whatnick/DrumLights/render/drumlight_still.png

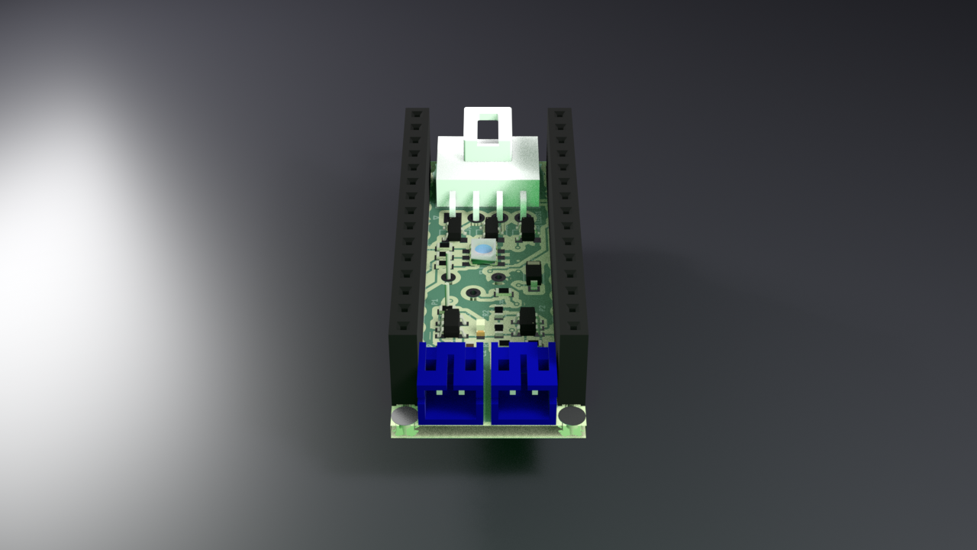
render/drumlight_still.png
