whatnick/DrumLights/Drumlight_PCB/Drumlight_PCB_bom.csv

Refs | Value | Footprint | Manufacturer | MPN | LCSC | DigiKey | Mouser
BAT1,PZO1 | CONN_01X02 | Drumlight_PCB:JST_PH_S2B-PH-K_02x2.00mm_Angled | JST | S2B-PH-K-S(LF)(SN) | C173752 | https://www.digikey.com/en/products/result?keywords=S2B-PH-K-S%28LF%29%28SN%29 | https://www.mouser.com/c/?q=S2B-PH-K-S%28LF%29%28SN%29
C1 | 10pF | Drumlight_PCB:C_0603 | Samsung Electro-Mechanics | CL10C100JB8NNNC | C1634 | https://www.digikey.com/en/products/result?keywords=CL10C100JB8NNNC | https://www.mouser.com/c/?q=CL10C100JB8NNNC
C2,C3 | 4.7uF | Drumlight_PCB:C_0603 | Samsung Electro-Mechanics | CL10A475KO8NNNC | C19666 | https://www.digikey.com/en/products/result?keywords=CL10A475KO8NNNC | https://www.mouser.com/c/?q=CL10A475KO8NNNC
D1 | LED | Drumlight_PCB:LED_0603 | Lite-On | LTST-C191KGKT | C125098 | https://www.digikey.com/en/products/result?keywords=LTST-C191KGKT | https://www.mouser.com/c/?q=LTST-C191KGKT
D2 | D_Schottky | Drumlight_PCB:D_SOD-123 | Jiangsu Changjing Electronics | B5819W SL | C8598 | https://www.digikey.com/en/products/result?keywords=B5819W%20SL | https://www.mouser.com/c/?q=B5819W%20SL
D3 | LED_RGB | Drumlight_PCB:LED_RGB_PLCC-6 | ams OSRAM | LRTB GFTM |  | https://www.digikey.com/en/products/result?keywords=LRTB%20GFTM | https://www.mouser.com/c/?q=LRTB%20GFTM
LEDS1 | CONN_01X04 | Drumlight_PCB:Molex_NanoFit_1x04x2.50mm_Angled | Molex | 105313-1204 | C586244 | https://www.digikey.com/en/products/result?keywords=105313-1204 | https://www.mouser.com/c/?q=105313-1204
P1,P2 | Analog,Digital | Drumlight_PCB:Socket_Strip_Straight_1x15
Q1,Q2,Q3 | BSS306N | Drumlight_PCB:SOT-23 | Infineon | BSS306N H6327 | C72769 | https://www.digikey.com/en/products/result?keywords=BSS306N%20H6327 | https://www.mouser.com/c/?q=BSS306N%20H6327
R1,R2,R6 | 10K | Drumlight_PCB:R_0603 | UNI-ROYAL | 0603WAF1002T5E | C25804 | https://www.digikey.com/en/products/result?keywords=0603WAF1002T5E | https://www.mouser.com/c/?q=0603WAF1002T5E
R3,R8,R9 | 100 | Drumlight_PCB:R_0603 | UNI-ROYAL | 0603WAF1000T5E | C22775 | https://www.digikey.com/en/products/result?keywords=0603WAF1000T5E | https://www.mouser.com/c/?q=0603WAF1000T5E
R4 | 100K | Drumlight_PCB:R_0603 | UNI-ROYAL | 0603WAF1003T5E | C25803 | https://www.digikey.com/en/products/result?keywords=0603WAF1003T5E | https://www.mouser.com/c/?q=0603WAF1003T5E
R5 | 470 | Drumlight_PCB:R_0603 | UNI-ROYAL | 0603WAF4700T5E | C23179 | https://www.digikey.com/en/products/result?keywords=0603WAF4700T5E | https://www.mouser.com/c/?q=0603WAF4700T5E
R7 | 5.1K | Drumlight_PCB:R_0603 | UNI-ROYAL | 0603WAF5101T5E | C23186 | https://www.digikey.com/en/products/result?keywords=0603WAF5101T5E | https://www.mouser.com/c/?q=0603WAF5101T5E
R10 | 150 | Drumlight_PCB:R_0603 | UNI-ROYAL | 0603WAF1500T5E | C22808 | https://www.digikey.com/en/products/result?keywords=0603WAF1500T5E | https://www.mouser.com/c/?q=0603WAF1500T5E
RV1 | 10K POT | Drumlight_PCB:Potentiometer_Bourns_3339P_Angular_ScrewUp | Bourns | 3339P-1-103LF |  | https://www.digikey.com/en/products/result?keywords=3339P-1-103LF | https://www.mouser.com/c/?q=3339P-1-103LF
SW1 | SW_SPST | Drumlight_PCB:SW_DIP_x1_W7.62mm_Slide_Copal_CHS-B | Nidec | CHS-01TB | C2680613 | https://www.digikey.com/en/products/result?keywords=CHS-01TB | https://www.mouser.com/c/?q=CHS-01TB
U1 | TLV9001 | Drumlight_PCB:SOT-23-5 | Texas Instruments | TLV9001IDBVR | C398363 | https://www.digikey.com/en/products/result?keywords=TLV9001IDBVR | https://www.mouser.com/c/?q=TLV9001IDBVR
U2 | MCP73831 | Drumlight_PCB:SOT-23-5 | Microchip | MCP73831T-2ACI/OT | C424093 | https://www.digikey.com/en/products/result?keywords=MCP73831T-2ACI/OT | https://www.mouser.com/c/?q=MCP73831T-2ACI/OT
