whatnick/DrumLights/(commit log)

2017-02-08 Initial import of PCB
    [Drumlight_PCB.kicad_pcb, Drumlight_PCB.sch]
2017-02-08 Added project
    [Drumlight_PCB.kicad_pcb]
2017-02-09 Completed route
    [Drumlight_PCB.kicad_pcb, Drumlight_PCB.sch]
2017-02-10 Cleaned up designators
    [Drumlight_PCB.kicad_pcb]
2017-02-10 Changed designators
    [Drumlight_PCB.kicad_pcb, Drumlight_PCB.sch]
2017-02-11 Added PCB name/date
    [Drumlight_PCB.kicad_pcb]
2017-02-14 Changed footprints to resistors
    [Drumlight_PCB.kicad_pcb, Drumlight_PCB.sch]
2017-02-15 Add part no field
    [Drumlight_PCB.kicad_pcb, Drumlight_PCB.sch]
2017-02-16 Added manf# to use KiCost
    [Drumlight_PCB.sch]
2017-02-16 Updated part no.
    [Drumlight_PCB.sch]
2017-02-19 Added a switch
    [Drumlight_PCB.kicad_pcb, Drumlight_PCB.sch]
2017-02-24 Changed power dip switch
    [Drumlight_PCB.kicad_pcb, Drumlight_PCB.sch]
2017-02-24 Update date
    [Drumlight_PCB.kicad_pcb]
2017-03-05 Added 3D models from local directory
    [Drumlight_PCB.kicad_pcb]
2017-03-07 Changed to relative path for JST
    [Drumlight_PCB.kicad_pcb]
2017-03-11 Changed QNMOS footprints to match datasheets
    [Drumlight_PCB.kicad_pcb, Drumlight_PCB.sch]
2017-03-21 Added support for RGB via new PCB
2026-11-08 Upgrade to KiCad 10, modernise firmware, document ESP32-S3 option
2026-11-08 Clean ERC/DRC, add project libraries and sourced BOM
    Relink footprints to a project library, add manufacturer/MPN/LCSC fields,
    rename PCB nets to match the schematic, refill zones, add PWR_FLAGs and set
    project ERC/DRC rules for the Nano shield.
2026-11-08 Add sourcing, platform and business case analysis
2026-11-08 Verify parts: TLV9001 op amp, 4.2V charger, single-row Nano-Fit header
2026-11-08 Add Blender turntable render; fix socket and SOD-123 3D models
